akkako/akaLinkCompact/README.md

# akaLink Compact

* CMSIS-DAP v2.1 在线调试功能
  * SWD 接口
  * JTAG 接口
* VCOM 功能
  * 支持最高 1Mbps 收发
* 5V 输出功能
  * 支持外接隔离器

## TODO List

- [X] 移植 CMSIS-DAP
- [X] 优化 SWD 速度
- [ ] 优化 JTAG 性能
- [ ] 优化 VCOM 性能
- [ ] 更多速度选项
- [ ] Bootloader
- [X] HID 配置功能
