akkako/akaLinkCompact/hardware/HWVer_A.01/akaLinkCompact.kicad_pcb

## KiCad design hardware/HWVer_A.01/akaLinkCompact.kicad_pcb (2026-03-18)

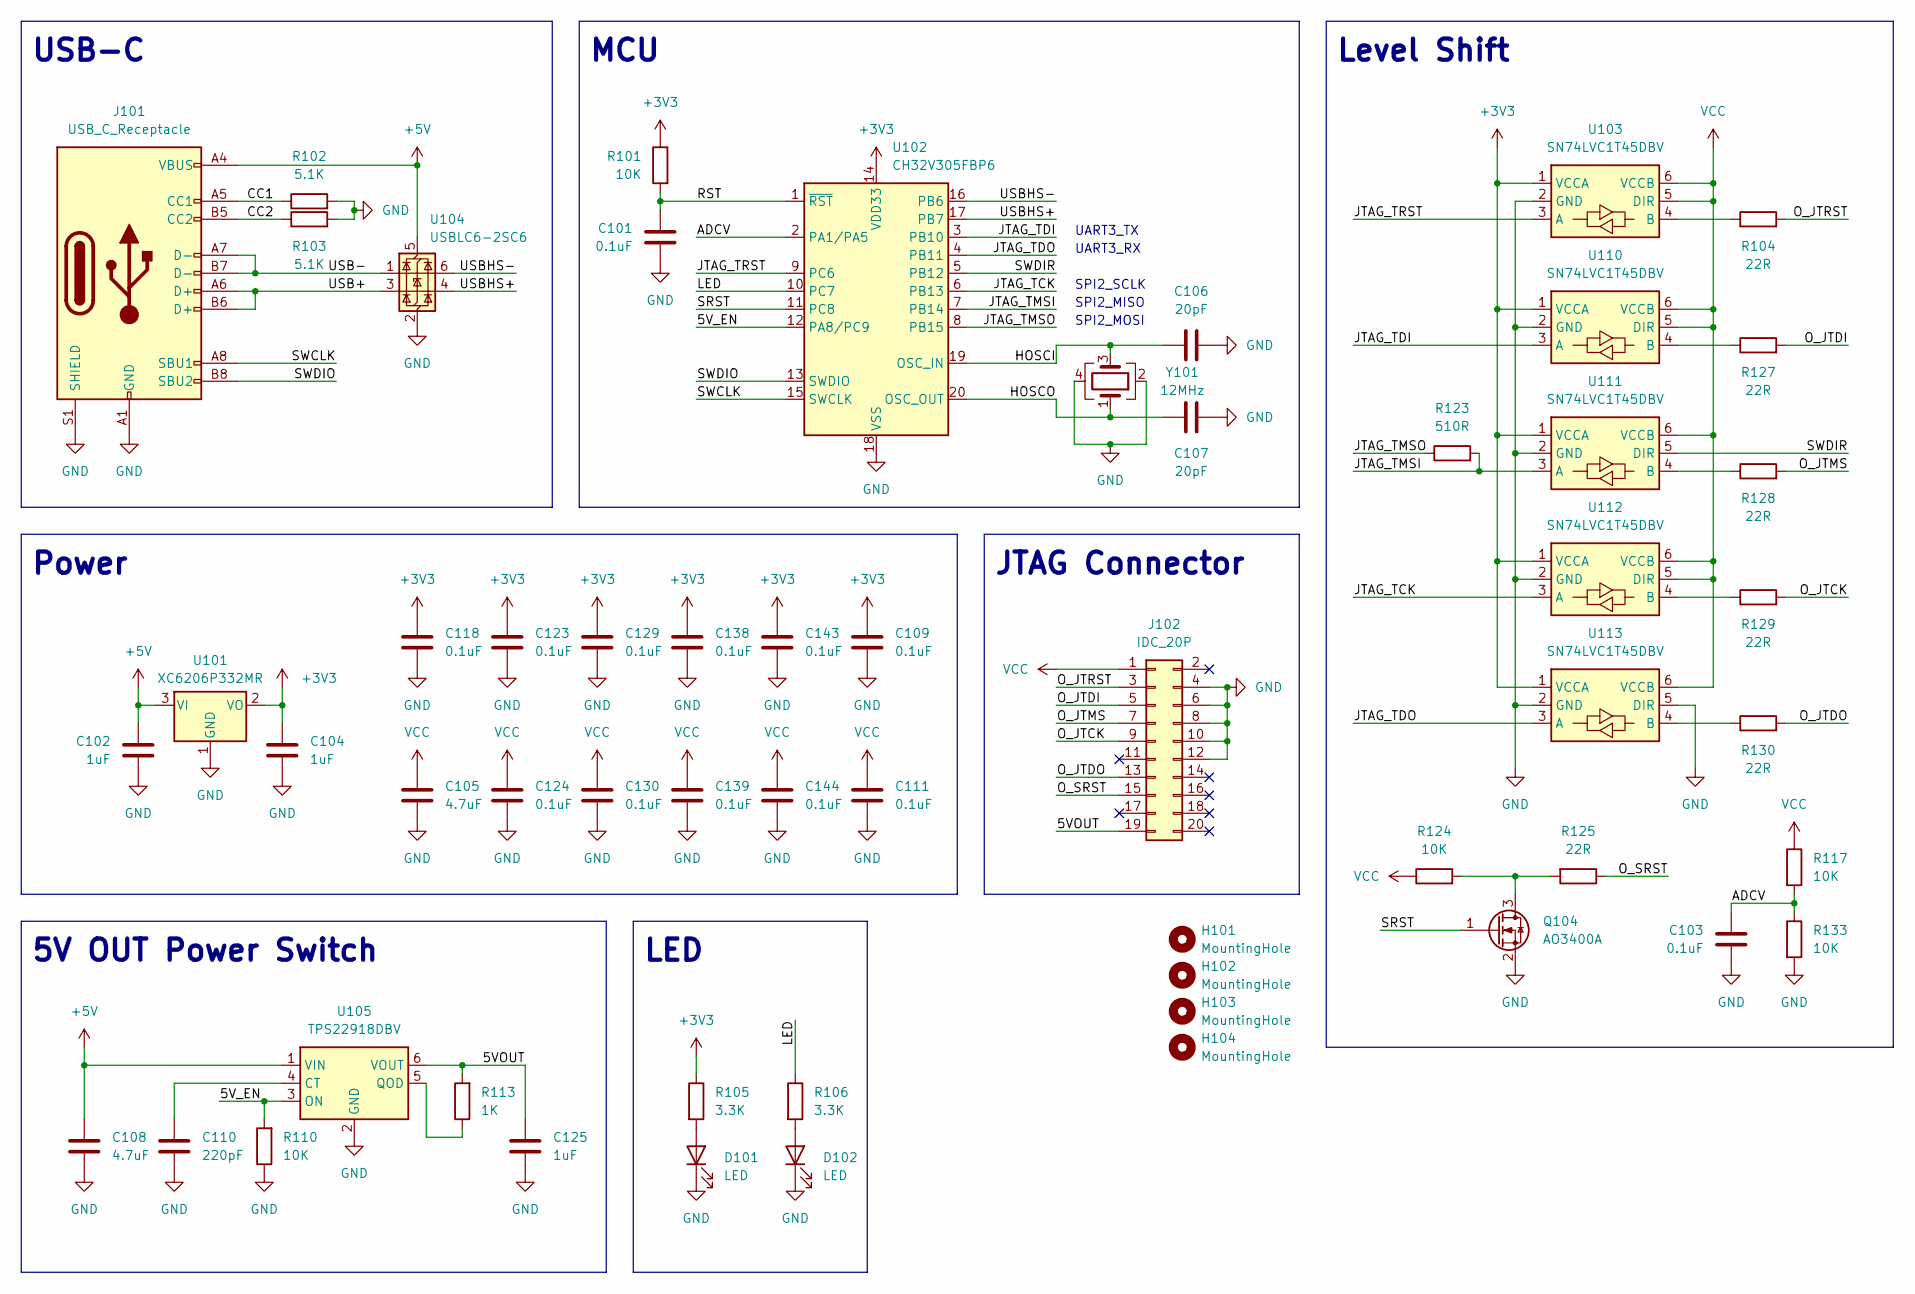
[picture p1: schematic akaLinkCompact.kicad_sch, akaLink Compact]

Parts:
C101, C103, C109, C111, C118, C123, C124, C129, C130, C138, C139, C143, C144: 0.1uF; C_0603_1608Metric
C102, C104, C125: 1uF; C_0603_1608Metric
C105, C108: 4.7uF; C_0603_1608Metric
C106, C107: 20pF; C_0603_1608Metric
C110: 220pF; C_0603_1608Metric
D101, D102: LED; LED_D3.0mm
H101, H102, H103, H104: MountingHole; MountingHole_2.5mm
J101: USB_C_Receptacle; USB_C_Receptacle_HRO_TYPE-C-31-M-12
J102: IDC_20P; IDC-Header_2x10_P2.54mm_Horizontal
Q104: AO3400A; SOT-23
R101, R110, R117, R124, R133: 10K; R_0603_1608Metric
R102, R103: 5.1K; R_0603_1608Metric
R104, R125, R127, R128, R129, R130: 22R; R_0603_1608Metric
R105, R106: 3.3K; R_0603_1608Metric
R113: 1K; R_0603_1608Metric
R123: 510R; R_0603_1608Metric
U101: XC6206P332MR; SOT-23-3
U102: CH32V305FBP6; TSSOP-20_4.4x6.5mm_P0.65mm
U103, U110, U111, U112, U113: SN74LVC1T45DBV; SOT-23-6
U104: USBLC6-2SC6; SOT-23-6
U105: TPS22918DBV; SOT-23-6
Y101: 12MHz; Crystal_SMD_3225-4Pin_3.2x2.5mm

Connections:
+3V3: C104.1, C109.1, C118.1, C123.1, C129.1, C138.1, C143.1, R101.1, R105.1, U101.2 (VO), U102.14 (VDD33), U103.1 (VCCA), U110.1 (VCCA), U111.1 (VCCA), U112.1 (VCCA), U113.1 (VCCA)
+5V: C102.1, C108.1, J101.A4 (VBUS), J101.A9 (VBUS), J101.B4 (VBUS), J101.B9 (VBUS), U101.3 (VI), U104.5 (VBUS), U105.1 (VIN)
/5VOUT: C125.1, J102.19, R113.2, U105.6 (VOUT)
/5V_EN: R110.2, U102.12 (PA8/PC9), U105.3 (ON)
/ADCV: C103.1, R117.2, R133.1, U102.2 (PA1/PA5)
/CC1: J101.A5 (CC1), R102.1
/CC2: J101.B5 (CC2), R103.1
/HOSCI: C106.2, U102.19 (OSC_IN), Y101.3
/HOSCO: C107.2, U102.20 (OSC_OUT), Y101.1
/JTAG_TCK: U102.6 (PB13), U112.3 (A)
/JTAG_TDI: U102.3 (PB10), U110.3 (A)
/JTAG_TDO: U102.4 (PB11), U113.3 (A)
/JTAG_TMSI: R123.2, U102.7 (PB14), U111.3 (A)
/JTAG_TMSO: R123.1, U102.8 (PB15)
/JTAG_TRST: U102.9 (PC6), U103.3 (A)
/LED: R106.1, U102.10 (PC7)
/O_JTCK: J102.9, R129.2
/O_JTDI: J102.5, R127.2
/O_JTDO: J102.13, R130.2
/O_JTMS: J102.7, R128.2
/O_JTRST: J102.3, R104.2
/O_SRST: J102.15, R125.1
/RST: C101.1, R101.2, U102.1 (~RST)
/SRST: Q104.1 (G), U102.11 (PC8)
/SWCLK: J101.A8 (SBU1), U102.15 (SWCLK)
/SWDIO: J101.B8 (SBU2), U102.13 (SWDIO)
/SWDIR: U102.5 (PB12), U111.5 (DIR)
/USB+: J101.A6 (D+), J101.B6 (D+), U104.3 (I/O2)
/USB-: J101.A7 (D-), J101.B7 (D-), U104.1 (I/O1)
/USBHS+: U102.17 (PB7), U104.4 (I/O2)
/USBHS-: U102.16 (PB6), U104.6 (I/O1)
GND: C101.2, C102.2, C103.2, C104.2, C105.2, C106.1, C107.1, C108.2, C109.2, C110.2, C111.2, C118.2, C123.2, C124.2, C125.2, C129.2, C130.2, C138.2, C139.2, C143.2, C144.2, D101.1 (K), D102.1 (K), J101.A1 (GND), J101.A12 (GND), J101.B1 (GND), J101.B12 (GND), J101.S1 (SHIELD), J102.4, J102.6, J102.8, J102.10, J102.12, Q104.2 (S), R102.2, R103.2, R110.1, R133.2, U101.1 (GND), U102.18 (VSS), U103.2 (GND), U104.2 (GND), U105.2 (GND), U110.2 (GND), U111.2 (GND), U112.2 (GND), U113.2 (GND), U113.5 (DIR), Y101.2, Y101.4
unnamed: D101.2 (A), R105.2
unnamed: D102.2 (A), R106.2
unnamed: Q104.3 (D), R124.2, R125.2
unnamed: R104.1, U103.4 (B)
unnamed: C110.1, U105.4 (CT)
unnamed: R113.1, U105.5 (QOD)
unnamed: R127.1, U110.4 (B)
unnamed: R128.1, U111.4 (B)
unnamed: R129.1, U112.4 (B)
unnamed: R130.1, U113.4 (B)
VCC: C105.1, C111.1, C124.1, C130.1, C139.1, C144.1, J102.1, R117.1, R124.1, U103.5 (DIR), U103.6 (VCCB), U110.5 (DIR), U110.6 (VCCB), U111.6 (VCCB), U112.5 (DIR), U112.6 (VCCB), U113.6 (VCCB)

Notes on the sheet:
SPI2_MOSI
Level Shift
5V OUT Power Switch
LED
USB-C
JTAG Connector
UART3_RX
SPI2_MISO
Power
SPI2_SCLK
UART3_TX
MCU

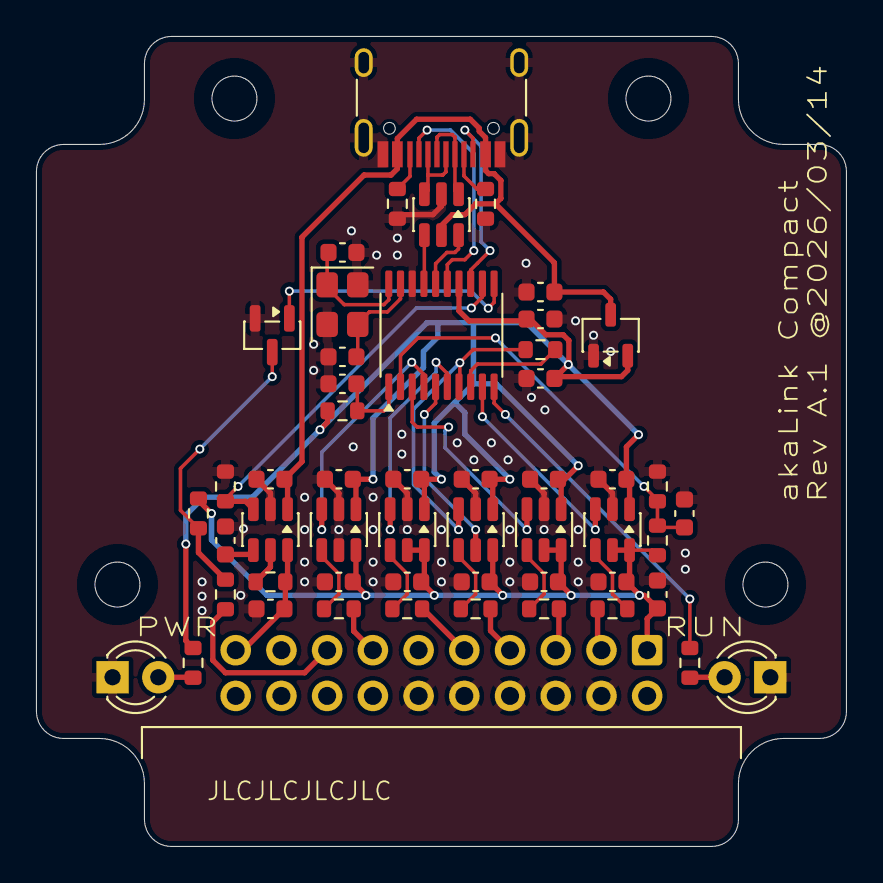
[picture p2: board akaLinkCompact.kicad_pcb from above]

Board: 2 copper layers, 45.0 x 45.0 mm, 57 parts (0 on the bottom side), 43 nets.
