akkako/akaLinkCompact/firmware/Application/app/main.c

#include "ch32v30x_misc.h"
#include "drv_gpio.h"
#include "drv_print.h"
#include "drv_systick.h"
#include "drv_usb2uart.h"
#include "app_param.h"


void chry_dap_init(uint8_t busid, uint32_t reg_base);
void chry_dap_handle(void);
void chry_dap_usb2uart_handle(void);

int main (void) {
    NVIC_PriorityGroupConfig (NVIC_PriorityGroup_2);
    drv_print_init();
    drv_systick_init();
    app_param_load();
    drv_gpio_init_misc();
    drv_gpio_init_as_hiz();
	drv_usb2uart_preinit();
	chry_dap_init(0, 0);

	while(1)
    {
		chry_dap_handle();
        chry_dap_usb2uart_handle();
	}
    return 0;
}
