akkako/akaLinkCompact/firmware/Application/drv/drv_clock.c

#include "ch32v30x.h"

#define SYSTEM_CLOCK_144MHz
// #define SYSTEM_CLOCK_156MHz
// #define SYSTEM_CLOCK_192MHz
// #define SYSTEM_CLOCK_216MHz

#ifdef SYSTEM_CLOCK_144MHz
uint32_t SystemCoreClock = 144000000;
#elif defined SYSTEM_CLOCK_156MHz
uint32_t SystemCoreClock = 156000000;
#elif defined SYSTEM_CLOCK_192MHz
uint32_t SystemCoreClock = 192000000;
#elif defined SYSTEM_CLOCK_216MHz
uint32_t SystemCoreClock = 216000000;
#endif

static void SetSysClock(void);

void SystemInit(void)
{
    #ifndef SYSTEM_CLOCK_144MHz
    // Set internal VDD LDO to 1.0V
    EXTEN->EXTEN_CTR = (EXTEN->EXTEN_CTR | (EXTEN_LDO_TRIM));
    // Wait for stable
    for(uint32_t i = 0; i < 10000; i++)
    {
        asm("nop");
    }
    #endif

    RCC->CTLR |= (uint32_t)0x00000001;
    RCC->CFGR0 &= (uint32_t)0xF0FF0000;
    RCC->CTLR &= (uint32_t)0xFEF6FFFF;
    RCC->CTLR &= (uint32_t)0xFFFBFFFF;
    RCC->CFGR0 &= (uint32_t)0xFF00FFFF;

#ifdef CH32V30x_D8C
    RCC->CTLR &= (uint32_t)0xEBFFFFFF;
    RCC->INTR = 0x00FF0000;
    RCC->CFGR2 = 0x00000000;
#else
    RCC->INTR = 0x009F0000;
#endif
    SetSysClock();
}

static void SetSysClock(void)
{
    __IO uint32_t StartUpCounter = 0, HSEStatus = 0;

    RCC->CTLR |= ((uint32_t)RCC_HSEON);

    /* Wait till HSE is ready and if Time out is reached exit */
    do
    {
        HSEStatus = RCC->CTLR & RCC_HSERDY;
        StartUpCounter++;
    } while ((HSEStatus == 0) && (StartUpCounter != HSE_STARTUP_TIMEOUT));

    if ((RCC->CTLR & RCC_HSERDY) != RESET)
    {
        HSEStatus = (uint32_t)0x01;
    }
    else
    {
        HSEStatus = (uint32_t)0x00;
    }

    if (HSEStatus == (uint32_t)0x01)
    {
        /* HCLK = SYSCLK */
        RCC->CFGR0 |= (uint32_t)RCC_HPRE_DIV1;
        /* PCLK2 = HCLK */
        RCC->CFGR0 |= (uint32_t)RCC_PPRE2_DIV1;
        /* PCLK1 = HCLK */
        RCC->CFGR0 |= (uint32_t)RCC_PPRE1_DIV2;

        /*  PLL configuration: PLLCLK = HSE * 12 = 144 MHz */
        RCC->CFGR0 &= ((uint32_t)~(RCC_PLLSRC | RCC_PLLXTPRE | RCC_PLLMULL));

#ifdef CH32V30x_D8
        RCC->CFGR0 |= (uint32_t)(RCC_PLLSRC_HSE | RCC_PLLXTPRE_HSE | RCC_PLLMULL18);
#else
#ifdef SYSTEM_CLOCK_144MHz
        RCC->CFGR0 |= (uint32_t)(RCC_PLLSRC_HSE | RCC_PLLXTPRE_HSE | RCC_PLLMULL12_EXTEN);
#elif defined SYSTEM_CLOCK_156MHz
        RCC->CFGR0 |= (uint32_t)(RCC_PLLSRC_HSE | RCC_PLLXTPRE_HSE | RCC_PLLMULL13_EXTEN);
#elif defined SYSTEM_CLOCK_192MHz
        RCC->CFGR0 |= (uint32_t)(RCC_PLLSRC_HSE | RCC_PLLXTPRE_HSE | RCC_PLLMULL16_EXTEN);
#elif defined SYSTEM_CLOCK_216MHz
        RCC->CFGR0 |= (uint32_t)(RCC_PLLSRC_HSE | RCC_PLLXTPRE_HSE | RCC_PLLMULL18_EXTEN);
#endif
#endif

        /* Enable PLL */
        RCC->CTLR |= RCC_PLLON;
        /* Wait till PLL is ready */
        while ((RCC->CTLR & RCC_PLLRDY) == 0)
        {
        }
        /* Select PLL as system clock source */
        RCC->CFGR0 &= (uint32_t)((uint32_t)~(RCC_SW));
        RCC->CFGR0 |= (uint32_t)RCC_SW_PLL;
        /* Wait till PLL is used as system clock source */
        while ((RCC->CFGR0 & (uint32_t)RCC_SWS) != (uint32_t)0x08)
        {
        }
    }
    else
    {
        /*
         * If HSE fails to start-up, the application will have wrong clock
         * configuration. User can add here some code to deal with this error
         */
    }
}
