akkako/akaLinkCompact/firmware/Bootloader/app/main.c

#include "ch32v30x_misc.h"
#include "drv_gpio.h"
#include "drv_systick.h"
#include "drv_bkp.h"
#include "flash_fat16.h"
#include "sys_define.h"
#include "ch32v30x_rcc.h"
#include "crc32.h"
#include "drv_usb.h"

volatile uint8_t g_app_download_finished = 0;
volatile uint8_t g_app_verify_state = 0;
volatile uint8_t g_app_strap_state = 0;
volatile uint8_t g_app_exception_reset = 0;

extern void usb_msc_init (uint8_t busid, uintptr_t reg_base);

static inline void check_app_integrity (void) {
    uint32_t app_length = *(uint32_t *)(APPLICATION_CODE_LENGTH_ADDR);
    if (app_length > APPLICATION_MAX_SIZE) {
        return;
    }
    uint32_t file_crc32 = *(uint32_t *)(APPLICATION_CODE_CRC32_ADDR);
    uint32_t calc_crc32 = crc32 (0x0D000721, (uint8_t *)APPLICATION_START_ADDR, app_length);

    if (calc_crc32 == file_crc32) {
        g_app_verify_state = 1;
    }
}

static inline void check_strap_state (void) {
    uint16_t strap_data = drv_bkp_read_reg();
    if (strap_data != 0x0000) {
        drv_bkp_write_reg (0);
    }

    if (strap_data == 0x0721) {
        g_app_strap_state = 1;
    }
}

static inline void check_exception_reset (void) {
    if (RCC->RSTSCKR & (RCC_WWDGRSTF | RCC_IWDGRSTF)) {
        RCC->RSTSCKR = (RCC_WWDGRSTF | RCC_IWDGRSTF);
        g_app_exception_reset = 1;
    }
}

static inline void jump_to_app (void) {
    drv_usb_enable_enum(0);
    NVIC_DisableIRQ (USBHS_IRQn);
    NVIC_DisableIRQ (USBFS_IRQn);
    NVIC_EnableIRQ (Software_IRQn);
    NVIC_SetPendingIRQ (Software_IRQn);
}

void SW_Handler (void) __attribute__ ((interrupt ("WCH-Interrupt-fast")));

void SW_Handler (void) {
    __asm ("li  a6, 0x4100");
    __asm ("jr  a6");

    while (1);
}

int main (void) {
    NVIC_PriorityGroupConfig (NVIC_PriorityGroup_2);
    drv_systick_init();
    drv_gpio_init_misc();
    drv_gpio_init_as_hiz();
    drv_bkp_init();

    check_app_integrity();
    check_strap_state();
    check_exception_reset();

    // 需要停在 Bootloader 的情况：
    // 1. app 校验失败
    // 2. app 主动 starp
    // 3. app 异常看门狗复位

    if (g_app_verify_state != 1 ||
        g_app_strap_state ||
        g_app_exception_reset) {
        // 初始化 bootloader
        fat16_file_init();
        usb_msc_init (0, 0);
    } else {
        // 跳转应用程序
        jump_to_app();
    }

    while (1) {
        if (g_app_download_finished == 1) {
            drv_systick_delay_ms (2000);
            drv_usb_enable_enum(0);
            NVIC_DisableIRQ (USBHS_IRQn);
            NVIC_DisableIRQ (USBFS_IRQn);
            NVIC_SystemReset();
        }
    }
    return 0;
}
