akkako/akaLinkCompact/(commit log)

2026-02-12 add project
    [akaLinkCompact.kicad_pcb, akaLinkCompact.kicad_sch]
2026-03-18 add hardware
    [akaLinkCompact.kicad_pcb, akaLinkCompact.kicad_sch]
2026-03-18 refactor(usb): 简化USB配置并移除未使用的功能
    移除MSC和WebUSB相关代码，优化USB端点配置
    更新链接脚本和调试输出级别，调整序列号长度
2026-03-18 feat: 添加RTT调试接口并优化SWD传输逻辑
    重构GPIO驱动，移除SPI相关代码
    添加RTT调试端点配置
    优化SWD传输性能，移除冗余代码
    更新项目配置和工具链版本
2026-03-19 refactor(gpio): 优化GPIO配置实现方式 fix(usb): 调整HID数据包大小并添加自定义HID支持
    [drv_gpio.c, main.c]
2026-05-20 add spi swd port
2026-05-20 opt spi swd
2026-05-20 port jtag pin driver
2026-05-22 optimize swd timming add uart comment
2026-05-24 refactor uart function
2026-05-24 port uart
2026-05-28 fix uart usbtx bug
    [drv_usb2uart.c]
2026-05-29 build: add sys config and adjust build includes
    1. 新增系统配置头文件sys_config.h并添加相关编译宏
    2. 向应用层Makefile和工程配置中添加sys目录头文件引用
    3. 重构usb转uart驱动，新增空闲中断配置宏与处理函数
    4. 优化usb主循环中uart数据处理流程
2026-06-03 fix webui hid protocol
    [app_param.c, app_param.h]
2026-06-06 refactor(dap): 清理冗余代码并调整DAP初始化参数
    1. 移除JTAG_DP.c中多余空行和SWD宏定义
    2. 移除main.c中冗余printf和空行
    3. 调整DAP_Setup参数传入输出模式
    4. 增大DAP包缓冲数量到8
    5. 重构SW_DP.c中条件编译代码
    6. 更新DAP结构体和函数声明
    7. 调整flash参数配置和保存逻辑
    8. 添加系统固件分区配置
2026-06-09 add new hardware
    [akaLinkCompact.kicad_pcb, akaLinkCompact.kicad_sch]
